christiantigor/ems/api/EMMA_Panel_Controller_API_v0.pdf

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
iii.
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
iii.
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
# 105 - EMS Panel Controller API

# Brief

API for connecting EMS Panel with web services.

# API

Register Panel Controller
Request:
192.168.128.69/emma/register18fe349936be
Notes:
192.168.128.69 is IP address of web server to use
18fe349936be is WiFi MAC address of Panel Controller
Response:
[{"getCmdURL":"(/emma/getCommand?apiKey=)","getCmdKey":"(ACM8XW24UDVY1GTV)","cmdExecURL":"(/e mma/cmdExecution?apiKey=)","cmdExecKey":"(ACM8XW24UDVY1GTL)","sendDataURL":"(/emma/sendData?a piKey=)","sendDataKey":"(99N5T6AH3NY4UKNA)"}]
Notes:
Format in JSON
There is no specific rules in generating the URLs and/or Keys

Verify Registration
Request:
192.168.128.69/emma/verifyACM8XW24UDVY1GTV
Notes:
ACM8XW24UDVY1GTV is getCmdKey Response:
Success: [{"status":"registered"}]
Failed: [{"status":"failed"}]
Notes:
Format in JSON

Get Command
Request:
192.168.128.69/emma/getCommand?apiKey=ACM8XW24UDVY1GTV
Response:
[{"id":”234”,"type":0,"address":"00262903424E","cmd":1},{"id":”345”,"type":0,"address":"00262903424F","cmd

## ":20},{"id":”234”,"type":1,"address":”1”,"cmd":1}]

Notes:
id is command ID
type
type = 0 is for device which has MAC address (e.g. IR Remote, RF Switch) type = 1 is for switch on Panel Controller
address
The address is MAC if type = 0
The address is switch channel (0-15) if type = 1 cmd
0 is turn OFF
1 is turn ON
18 - 30 are specific for Air Conditioner (it represents temperature in Celcius) Send Execution Status
Request:
Success: 192.168.128.69/emma/cmdExecution?apiKey=ACM8XW24UDVY1GTL&id="234"&status="success" Failed: 192.168.128.69/emma/cmdExecution?apiKey=ACM8XW24UDVY1GTL&id="234"&status="failed" Notes:
id is command ID
Response:
Check if server return 200 OK

Send Data
Request:
192.168.128.69/emma/sendData?apiKey=99N5T6AH3NY4UKNA&energy=123.45 Response:
Check if server return 200 OK

6.
a.
b.

Send Device (IR Remote, RF Switch) List - Not yet Request:
Response:
