christiantigor/ems/board_ems/ems_mbed/ems_mbed_rev_a_polygon.pdf

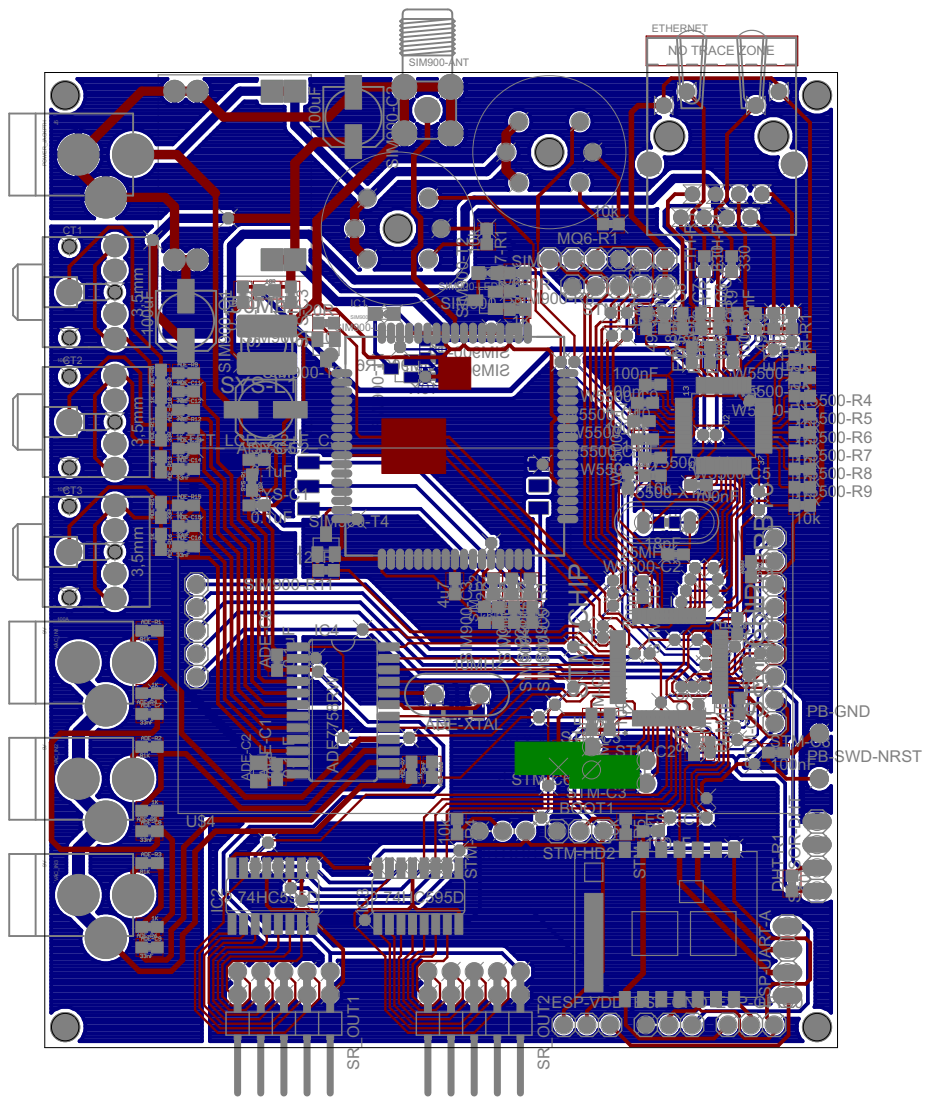
[picture p1: page 1]
