christiantigor/ems/(list of files, drawings)

Other design files:
document/MB1136C_schematic_layout/Connectors.SchDoc
document/MB1136C_schematic_layout/MB1136.PcbDoc
document/MB1136C_schematic_layout/MB1136.PrjPCB
document/MB1136C_schematic_layout/MB1136.SchDoc
document/MB1136C_schematic_layout/MB1136.SCHLIB
document/MB1136C_schematic_layout/MCU_64.SchDoc
document/MB1136C_schematic_layout/ST_LINK_V2-1.SCHDOC
