christiantigor/ems/board_ems/esp_converter/esp_converter.brd

## EAGLE design board_ems/esp_converter/esp_converter.brd (2015-05-25)

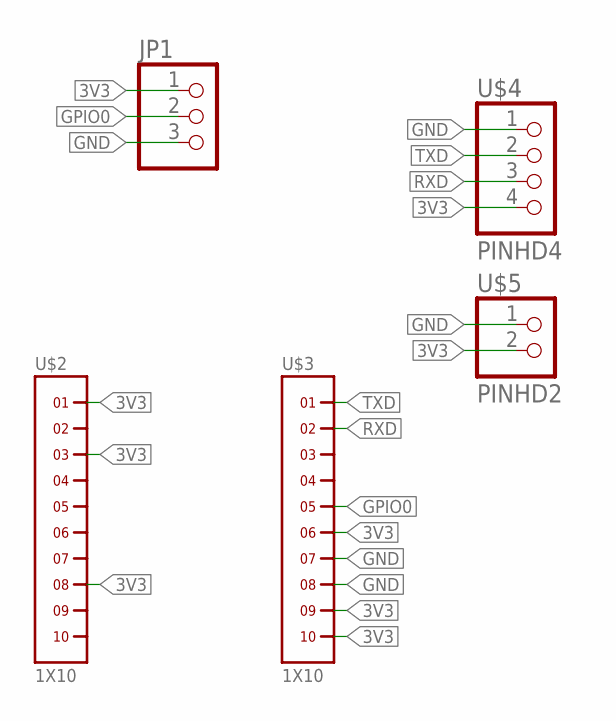
[picture p8: schematic esp_converter.sch]

Parts:
JP1: PINHD-1X3; 1X03
U$2, U$3: 1X10
U$4: PINHD4
U$5: PINHD2

Connections:
3V3: JP1.1, U$2.1, U$2.3, U$2.8, U$3.6, U$3.9, U$3.10, U$4.4, U$5.2
GND: JP1.3, U$3.7, U$3.8, U$4.1, U$5.1
GPIO0: JP1.2, U$3.5
RXD: U$3.2, U$4.3
TXD: U$3.1, U$4.2

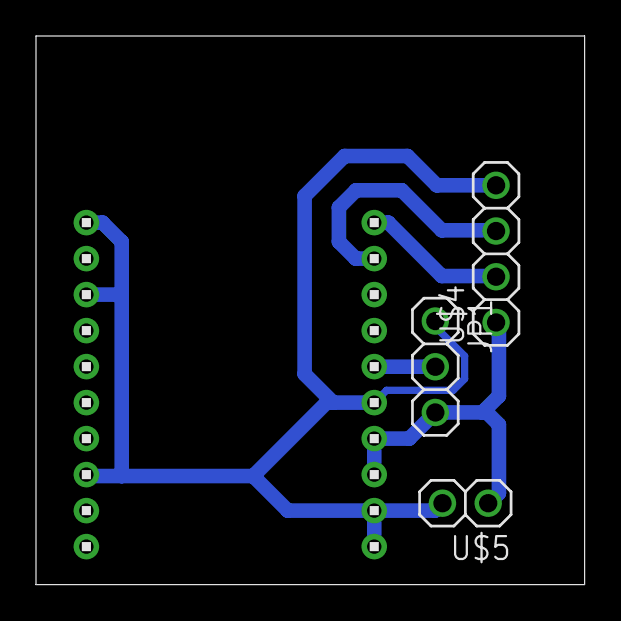
[picture p9: board esp_converter.brd from above]

Board: 2 copper layers, 30.5 x 30.5 mm, 5 parts (0 on the bottom side), 5 nets.
