christiantigor/ems/board_ems/eth_module/eth_module.brd

## EAGLE design board_ems/eth_module/eth_module.brd (2015-04-13)

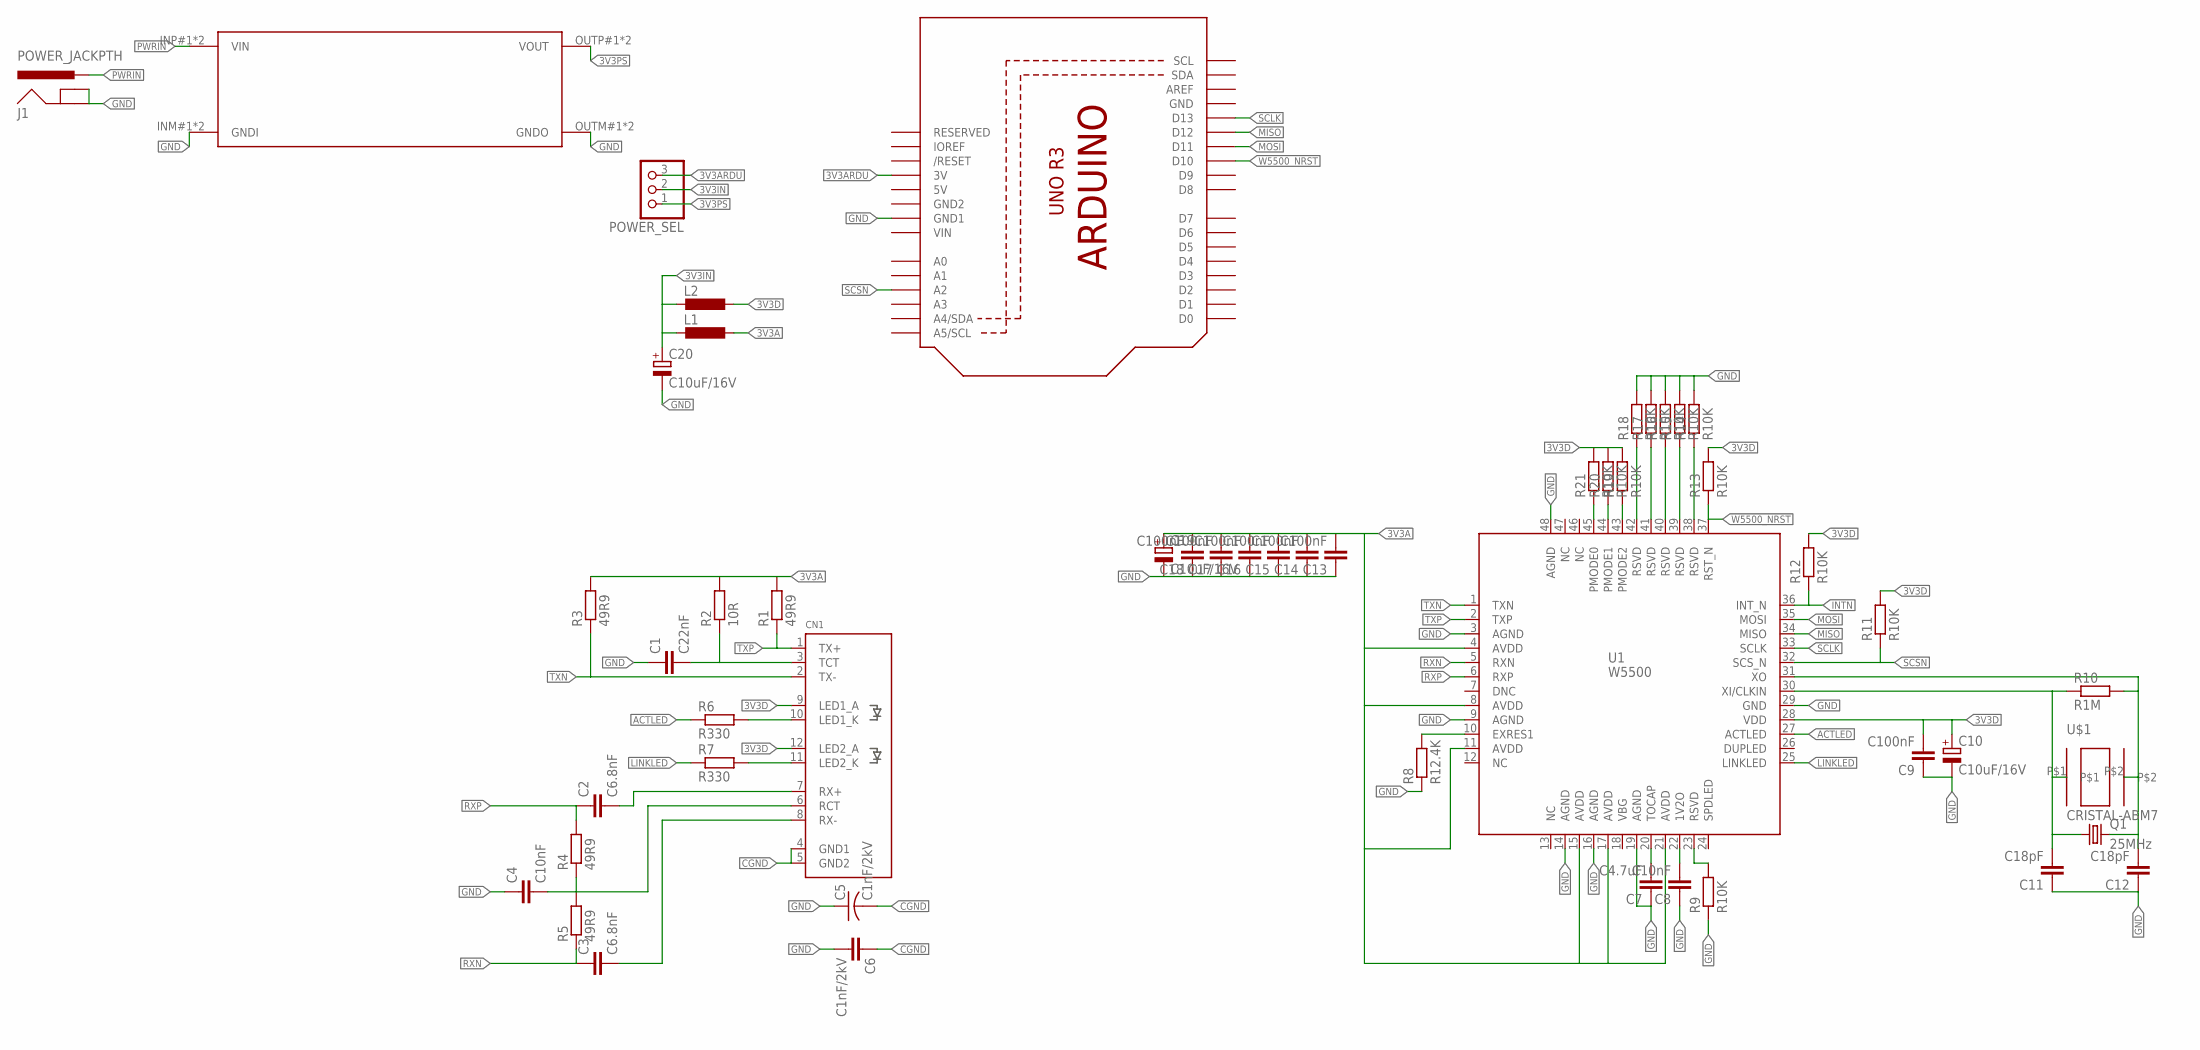
[picture p16: schematic eth_module.sch]

Parts:
C1: C22nF; C0603
C2, C3: C6.8nF; C0603
C4, C8: C10nF; C0603
C5: C1nF/2kV; C025-025X050
C6: C1nF/2kV; C0603
C7: C4.7uF; C0603
C9, C13, C14, C15, C16, C17, C18: C100nF; C0603
C10, C19, C20: C10uF/16V; 153CLV-0605
C11, C12: C18pF; C0603
CN1: RJ45J0026D21BNL; RJ45_PULSEJACK
J1: POWER_JACKPTH; POWER_JACK_PTH
L1, L2: L-EUL2012C; L2012C
POWER_SEL: PINHD-1X3; 1X03
Q1: 25MHz; HC49/S
R1, R3, R4, R5: 49R9; R0603
R2: 10R; R0603
R6, R7: R330; R0603
R8: R12.4K; R0805
R9, R11, R12, R13, R14, R15, R16, R17, R18, R19, R20, R21: R10K; R0603
R10: R1M; R0603
U1: W5500
U2: ARDUINOR3-DIMENSION; ARDUINOR3
U$1: CRISTAL-ABM7
U$2: DCDCMODULE_SMALL; DCDCMODULE-SMALL

Connections:
3V3A: C13.2, C14.2, C15.2, C16.2, C17.2, C18.2, C19.+, L1.1, R1.2, R2.2, R3.2, U1.4 (AVDD), U1.8 (AVDD), U1.11 (AVDD), U1.15 (AVDD), U1.17 (AVDD), U1.21 (AVDD)
3V3ARDU: POWER_SEL.3, U2.3V
3V3D: C9.2, C10.+, CN1.9 (LED1_A), CN1.12 (LED2_A), L2.1, R11.2, R12.2, R13.2, R19.2, R20.2, R21.2, U1.28 (VDD)
3V3IN: C20.+, L1.2, L2.2, POWER_SEL.2
3V3PS: POWER_SEL.1, U$2.OUTP#1 (VOUT), U$2.OUTP#2 (VOUT)
5VPS: U2.5V
ACTLED: R6.1, U1.27 (ACTLED)
CGND: C5.2, C6.1, CN1.4 (GND1), CN1.5 (GND2)
GND: C1.1, C4.1, C5.1, C6.2, C7.1, C8.1, C9.1, C10.-, C11.1, C12.1, C13.1, C14.1, C15.1, C16.1, C17.1, C18.1, C19.-, C20.-, J1.GND, J1.GNDBREAK, R8.1, R9.1, R14.2, R15.2, R16.2, R17.2, R18.2, U1.3 (AGND), U1.9 (AGND), U1.14 (AGND), U1.16 (AGND), U1.19 (AGND), U1.29 (GND), U1.48 (AGND), U2.GND, U2.GND1, U$2.INM#1 (GNDI), U$2.INM#2 (GNDI), U$2.OUTM#1 (GNDO), U$2.OUTM#2 (GNDO)
GND2: U2.GND2
INTN: R12.1, U1.36 (INT_N)
LINKLED: R7.1, U1.25 (LINKLED)
MISO: U1.34 (MISO), U2.D12
MOSI: U1.35 (MOSI), U2.D11
unnamed: CN1.10 (LED1_K), R6.2
unnamed: C1.2, CN1.3 (TCT), R2.1
unnamed: CN1.11 (LED2_K), R7.2
unnamed: C2.2, CN1.7 (RX+)
unnamed: C7.2, U1.20 (TOCAP)
unnamed: C4.2, CN1.6 (RCT), R4.1, R5.2
unnamed: R9.2, U1.23 (RSVD)
unnamed: C3.2, CN1.8 (RX-)
unnamed: R8.2, U1.10 (EXRES1)
unnamed: C11.2, Q1.1, R10.1, U1.30 (XI/CLKIN), U$1.P$1
unnamed: C8.2, U1.22 (1V2O)
unnamed: C12.2, Q1.2, R10.2, U1.31 (XO), U$1.P$2
unnamed: R14.1, U1.38 (RSVD)
unnamed: R15.1, U1.39 (RSVD)
unnamed: R16.1, U1.40 (RSVD)
unnamed: R17.1, U1.41 (RSVD)
unnamed: R18.1, U1.42 (RSVD)
unnamed: R21.1, U1.45 (PMODE0)
unnamed: R20.1, U1.44 (PMODE1)
unnamed: R19.1, U1.43 (PMODE2)
PWRIN: J1.PWR, U$2.INP#1 (VIN), U$2.INP#2 (VIN)
RXN: C3.1, R5.1, U1.5 (RXN)
RXP: C2.1, R4.2, U1.6 (RXP)
SCLK: U1.33 (SCLK), U2.D13
SCSN: R11.1, U1.32 (SCS_N), U2.A2
TXN: CN1.2 (TX-), R3.1, U1.1 (TXN)
TXP: CN1.1 (TX+), R1.1, U1.2 (TXP)
VIN: U2.VIN
W5500_NRST: R13.1, U1.37 (RST_N), U2.D10

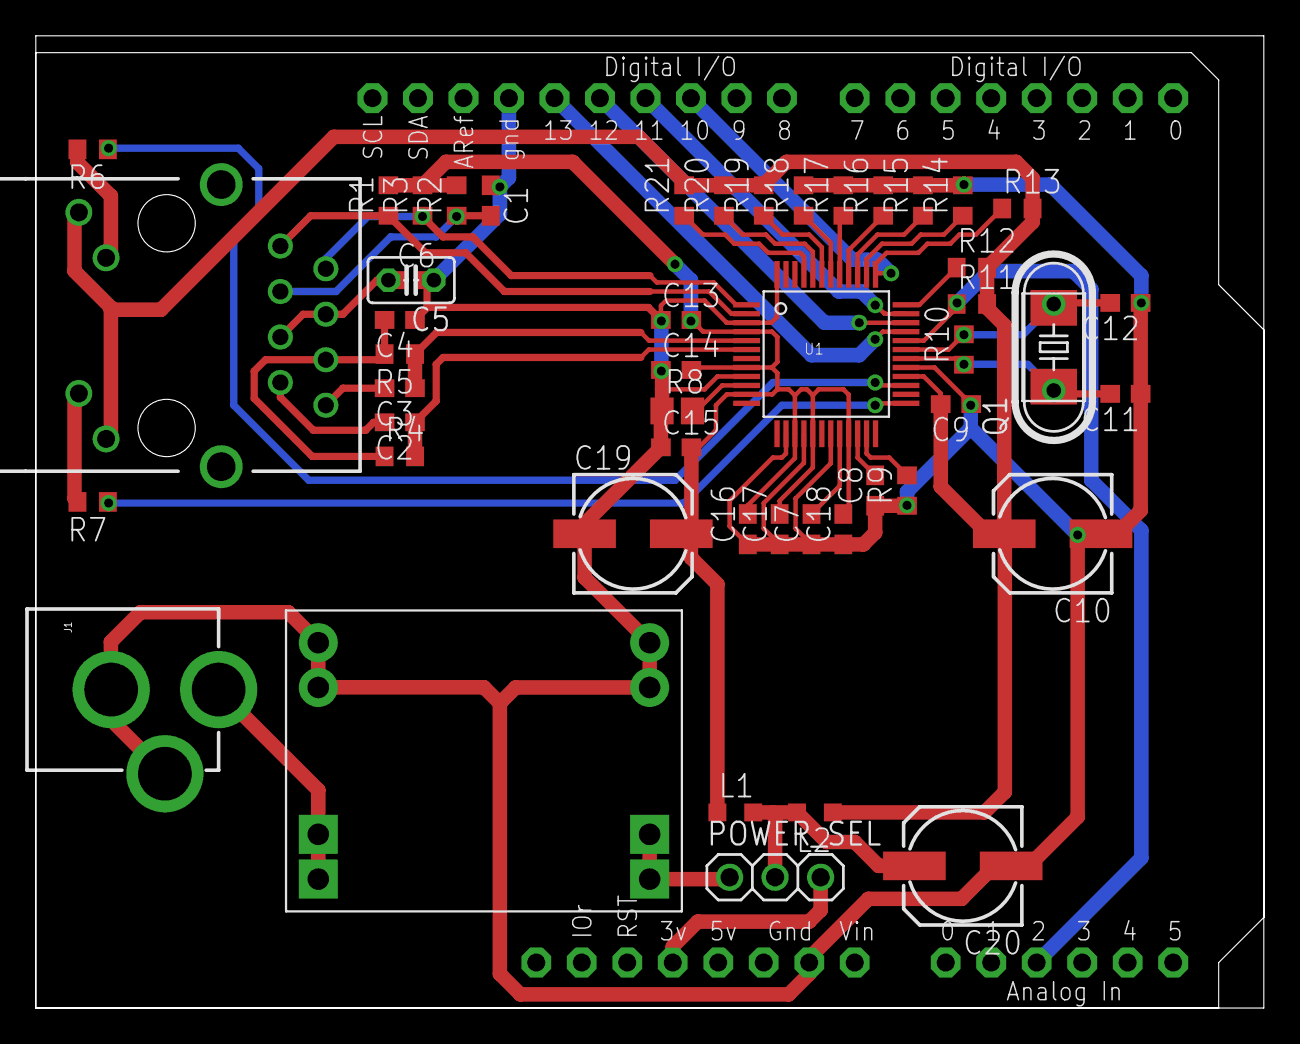
[picture p17: board eth_module.brd from above]

Board: 2 copper layers, 68.6 x 54.3 mm, 51 parts (0 on the bottom side), 40 nets.
