christiantigor/ems/board_ems/ade_7753/ade_7753.brd

## EAGLE design board_ems/ade_7753/ade_7753.brd (2015-03-23)

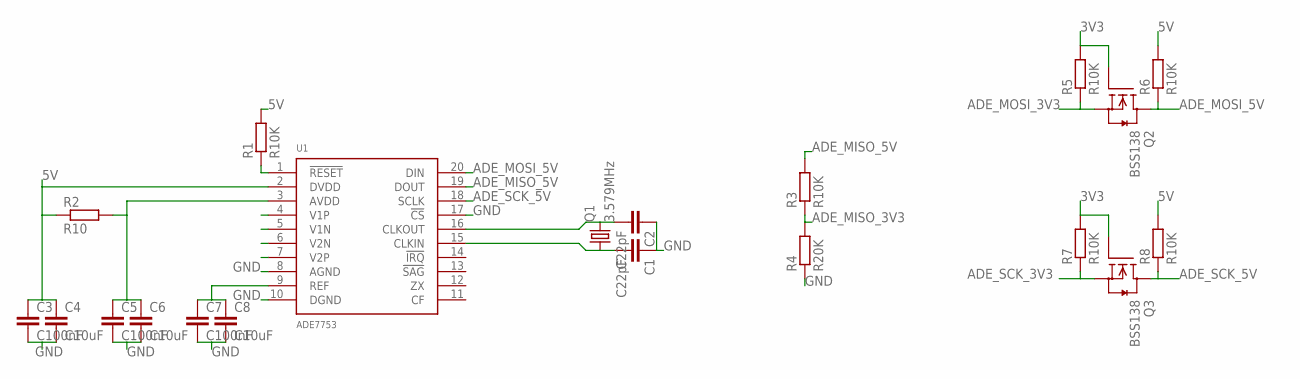
[picture p18: schematic ade_7753.sch]

Parts:
C1, C2: C22pF; C0805
C3, C5, C7: C100nF; C0805
C4, C6, C8: C10uF; C0805
Q1: 3.579MHz; HC49/S
Q2, Q3: BSS138; SOT23
R1, R3, R5, R6, R7, R8: R10K; M0805
R2: R10; M0805
R4: R20K; M0805
U1: ADE7753; SSOP-20

Connections:
3V3: Q2.1 (G), Q3.1 (G), R5.2, R7.2
5V: C3.1, C4.1, R1.2, R2.1, R6.2, R8.2, U1.2 (DVDD)
ADE_MISO_3V3: R3.1, R4.2
ADE_MISO_5V: R3.2, U1.19 (DOUT)
ADE_MOSI_3V3: Q2.2 (S), R5.1
ADE_MOSI_5V: Q2.3 (D), R6.1, U1.20 (DIN)
ADE_SCK_3V3: Q3.2 (S), R7.1
ADE_SCK_5V: Q3.3 (D), R8.1, U1.18 (SCLK)
GND: C1.1, C2.1, C3.2, C4.2, C5.2, C6.2, C7.2, C8.2, R4.1, U1.8 (AGND), U1.10 (DGND), U1.17 (!CS)
unnamed: C1.2, Q1.1, U1.15 (CLKIN)
unnamed: C2.2, Q1.2, U1.16 (CLKOUT)
unnamed: R1.1, U1.1 (!RESET)
unnamed: C5.1, C6.1, R2.2, U1.3 (AVDD)
unnamed: C7.1, C8.1, U1.9 (REF)

Board: 2 copper layers, 20 parts (0 on the bottom side), 14 nets, no tracks yet.
