christiantigor/ems/(commit log)

2015-03-23 init board
    [Connectors.SchDoc, MB1136.PcbDoc, MB1136.PrjPCB, MB1136.SCHLIB, MB1136.SchDoc, MCU_64.SchDoc, ST_LINK_V2-1.SCHDOC, ade_7753.brd]
2015-03-25 add dht, mq6, and mq7 sensors
    [ems_mbed.brd, ems_mbed.sch]
2015-03-25 rename edited files
    [ems_mbed_rev_a.brd, ems_mbed_rev_a.sch]
2015-03-28 add grber, chg ems_mbed w/ corct ones, del oth file
    [ems_mbed.brd, ems_mbed.sch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]
2015-04-08 add ems_mbed_rev_b
    [ems_mbed_rev_b.brd, ems_mbed_rev_b.sch, eth_module.brd, eth_module.sch]
2015-04-13 add eth_module
    [eth_module.brd, eth_module.sch, tigor_mbed_rev_b_print.brd, tigor_mbed_rev_b_print.sch]
2015-05-25 add doc for SLA
    [esp_converter.brd, esp_converter.sch, multikarya_mbed_rev_b_print.brd, multikarya_mbed_rev_b_print.sch]
2015-06-15 add esp_mqtt_revA code using Tigor's thingfabric
    [bontor_mbed_lowpan_rev_f.brd, bontor_mbed_lowpan_rev_f.sch]
